leapmotion/ProjectNorthStar/README.md

# Project North Star

Project North Star Headset (http://blog.leapmotion.com/northstar/)

Community organized instructions here: https://project-north-star.gitbook.io/project-north-star/

Hardware BOM, fabrication, and assembly instructions start here: https://github.com/leapmotion/ProjectNorthStar/tree/master/Mechanical

Software setup and calibration starts here: https://github.com/leapmotion/ProjectNorthStar/tree/master/Software

## Additional Resources

* Join the community for the bleeding edge updates on [Discord](https://discord.gg/NghjdX7)
* Scroll through the latest posts on [Reddit](https://www.reddit.com/r/ProjectNorthStar/)
* Keep up with our project updates on [Leap Motion Blog](http://blog.leapmotion.com/)
