leapmotion/ProjectNorthStar/Electronics/README.md

# Project North Star: Electronics

These folders contain the Schematic, Firmware, and Bill of Materials used in building and programming the display driver board on the Project North Star AR Headset.
