leapmotion/ProjectNorthStar/Mechanical/imgs/exploded-view.png

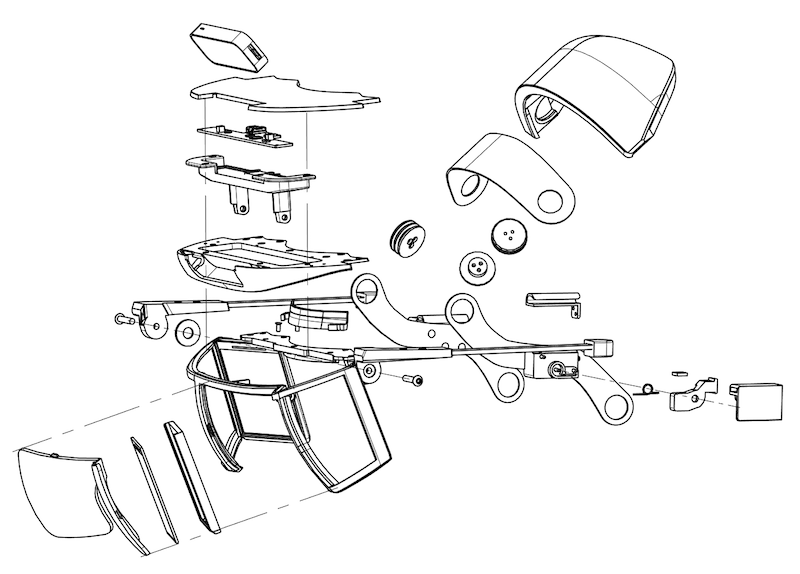
Mechanical/imgs/exploded-view.png
