leapmotion/ProjectNorthStar/Mechanical/imgs/headgear-crossection.jpg

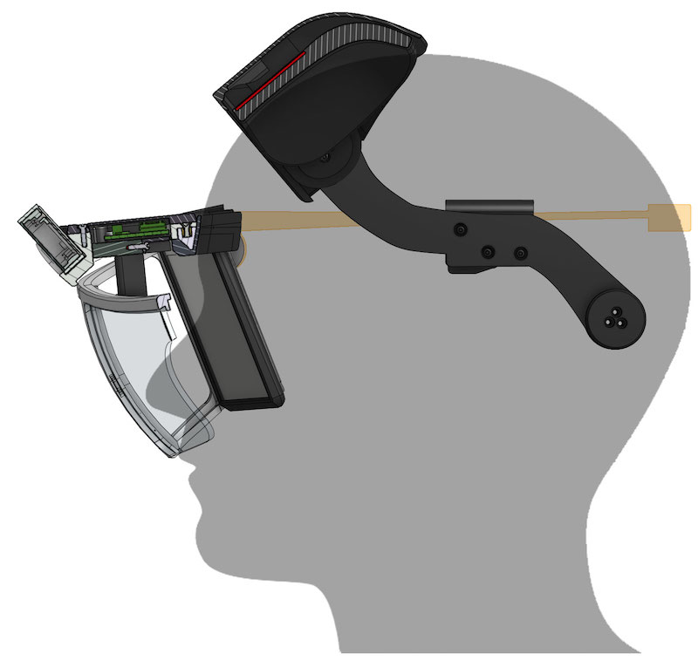
Mechanical/imgs/headgear-crossection.jpg
