leapmotion/ProjectNorthStar/Mechanical/imgs/hero-north-star-release.jpg

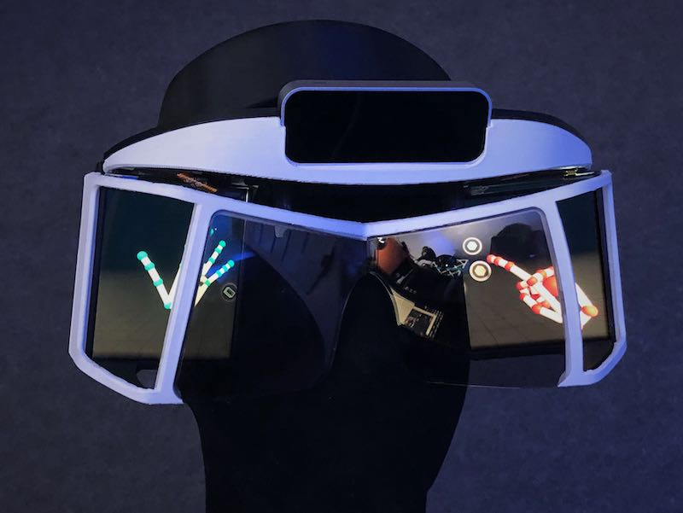
Mechanical/imgs/hero-north-star-release.jpg
