leapmotion/ProjectNorthStar/Mechanical/imgs/north-star-release-3.jpg

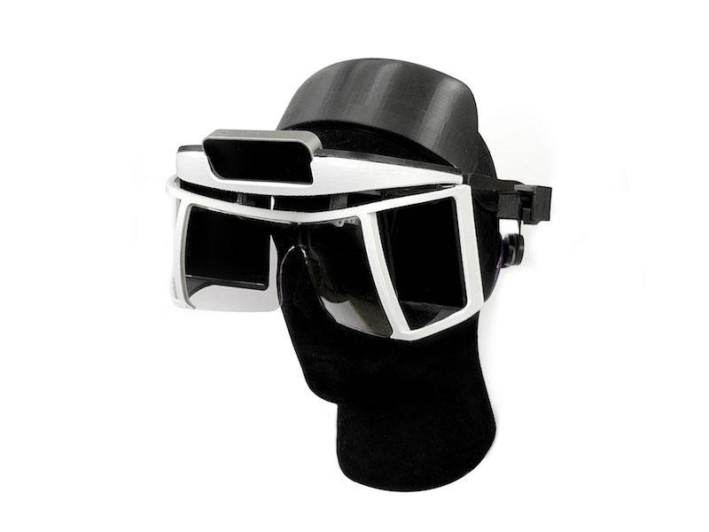
Mechanical/imgs/north-star-release-3.jpg
