leapmotion/ProjectNorthStar/Electronics/Hardware/Bill of Materials-Project North Star.xls

Designator | Description | Quantity | Manufacturer | Manufacturer P/N | Supplier | Supplier P/N
C2, C3, C4, C11, C12, C13, C15, C17, C19, C21, C23, C25 | Capacitor, 0.1uF, 10V, 10%, 0201, Ceramic, X5R | 12 | Murata | GRM033R61A104KE15D | Mouser | 581-81-GRM033R61A104KE5D
C5, C6, C10, C14, C16, C18, C20, C22, C24, C35, C37, C40, C41, C55, C56, C57, C60 | Capacitor, 1.0uF, 10V, 10%, 0402, Ceramic, X5R | 17 | TDK | C1005X5R1A105K050BB | Digikey | 445-4114-6-ND
C7, C8 | Capacitor, 6pF, 50V, 0.1pF, 0201, Ceramic, C0G(NP0) | 2 | Murata | GRM0335C1H6R0BA01D | Digikey | 490-11339-1-ND
C9 | Capacitor, 2.2uF, 6.3V, 20%, 0402, Ceramic, X5R | 1 | TDK | C1005X5R0J225M050BC | Digikey | 445-4999-1-ND
C26, C27, C49, C50 | Capacitor, 18pF, 50V, 2%, 0201, Ceramic, C0G(NP0) | 4 | Murata | GRM0335C1H180GA01D | Digikey | 490-11310-1-ND
C28, C29, C30, C31, C32, C33, C38, C39, C42, C43, C44 | Capacitor, 10uF, 10V, 10%, 0603, Ceramic, X5R | 11 | Murata | GRM188R61A106KE69D | Digikey | 490-10474-1-ND
C34 | Capacitor, 15pF, 50V, 2%, 0201, Ceramic, C0G(NP0) | 1 | Murata | GRM0335C1H150GA01D | Digikey | 490-11309-1-ND
C36, C58, C59 | Capacitor, 12pF, 50V, 2%, 0201, Ceramic, C0G(NP0) | 3 | Murata | GRM0335C1H120GA01D | Digikey | 490-11308-1-ND
C45, C46, C47, C48 | Capacitor, 47uF, 10V, 20%, 0805, Ceramic, X5R | 4 | Murata | GRM21BR61A476ME15L | Mouser | 81-GRM21BR61A476ME15L
C51, C52, C53, C54, C61, C62 | Capacitor, 10uF, 50V, 10%, 1206, Ceramic, X7R | 6 | Samsung | CL31B106KBHNNNE | Digikey | 1276-6767-1-ND
CON2 | Connector, Generic, Header, 2POS, 2.54mm | 1 | Generic | Generic
D1 | LED, 635nm, 140deg, , 20mA, , 1.6mm x 0.8mm, -30C - 85C | 1 | Dialight | 598-8010-107F | Mouser | 645-598-8010-107F
D2, D3, D4, D5 | Diode, -40C - 150C, SOD-323 | 4 | Toshiba | CUS10S40,H3F | Mouser | 757-CUS10S40H3F
D6 | LED, 593nm, 140deg, , 20mA, , 1.6mm x 0.8mm, -30C - 85C | 1 | Dialight | 598-8040-107F | Mouser | 645-598-8040-107F
FB1, FB2, FB3 | FERRITE CHIP BEAD 600 OHM SMD | 3 | TDK | MPZ1608S601A | Digikey | 445-2205-1-ND
J1 | Connector, TE Connectivity, Receptacle, 20POS, 0.9mm | 1 | TE Connectivity | 2129320-3 | Digikey | A120537CT-ND
J2 | Connector, FCI, Right Angle, 12POS, 0.5mm | 1 | FCI | 10051922-1210ELF | Digikey | 609-1236-6-ND
J3, J4 | Connector, Kyocera, Receptacle, 50POS, 0.35mm | 2 | Kyocera | 245863050104829+ | Kyocera | 245863050104829+
L1, L4 | FIXED IND 4.7UH 1.4A 216 MOHM | 2 | Murata | DFE252012R-H-4R7M=P2 | Digikey | 490-10658-1-ND
L2, L3 | INDUCTOR 1.0UH 20% 1600MA 1008 | 2 | Murata | LQM2HPN1R0MG0L | Digikey | 490-5112-1-ND
L5, L6 | Fixed Inductors XAL4040 AEC-Q200 15 uH 20 % 2.8 A | 2 | Coilcraft | XAL4040-153MEB | Mouser | 994-XAL4040-153MEB
LCD1, LCD2 | 3.5inch 1440RGB*1600 TFT-LCD Module | 2 | BOE | VS035ZSM-NW0-69P0 | BOE | VS035ZSM-NW0-69P0
Q1, Q2 | Transistor, NFET_DUAL, 2.2Ohm, 200mA, 120mW, SOT-563, -55C - 150C | 2 | Rohm Semiconductor | EM6K34T2CR | Digikey | EM6K34T2CRCT-ND
R1, R2, R3, R4, R20 | Resistor, 1M, 1/20W, 1%, 0201 | 5 | Panasonic Electronic Components | ERJ-1GEF1004C | Digikey | P1.00MABCT-ND
R6, R7 | Resistor, 4.7K, 1/20W, 1%, 0201 | 2 | Panasonic Electronic Components | ERJ-1GEF4701C | Digikey | P4.70KABDKR-ND
R8, R9, R10, R12, R14, R43 | Resistor, 10K, 1/20W, 5%, 0201 | 6 | Panasonic Electronic Components | ERJ-1GEJ103C | Digikey | P10KAGCT-ND
R11, R13, R15, R21 | Resistor, 1K, 1/20W, 5%, 0201 | 4 | Panasonic Electronic Components | ERJ-1GEJ102C | Digikey | P1.0KAGCT-ND
R16, R18, R19, R24, R32 | Resistor, 0R, 1/10W, Jumper, 0402 | 5 | Panasonic Electronic Components | ERJ-2GE0R00X | Digikey | P0.0JCT-ND
R23 | Resistor, 200K, 1/20W, 1%, 0201 | 1 | Panasonic Electronic Components | ERJ-1GEF2003C | Digikey | P200KABCT-ND
R25 | Resistor, 36.5K, 1/20W, 1%, 0201 | 1 | Panasonic Electronic Components | ERJ-1GEF3652C | Digikey | P36.5KABCT-ND
R26 | Resistor, 560K, 1/20W, 1%, 0201 | 1 | Yageo | RC0201FR-07560KL | Digikey | YAG2728CT-ND
R27, R34 | Resistor, 30K, 1/20W, 1%, 0201 | 2 | Panasonic Electronic Components | ERJ-1GEF3002C | Digikey | P30.0KABCT-ND
R28, R29 | Resistor, 150K, 1/20W, 1%, 0201 | 2 | Panasonic Electronic Components | ERJ-1GEF1503C | Digikey | P150KABCT-ND
R30 | Resistor, 715K, 1/20W, 1%, 0201 | 1 | Yageo | RC0201FR-07715KL | Digikey | YAG2785CT-ND
R31 | Resistor, 10R, 1/10W, 1%, 0402 | 1 | Panasonic | ERJ-2RKF10R0X | Mouser | 667-ERJ-2RKF10R0X
R33 | Resistor, 90.9K, 1/20W, 1%, 0201 | 1 | Panasonic Electronic Components | ERJ-1GEF9092C | Digikey | P90.9KABCT-ND
R35, R36 | Resistor, 750K, 1/20W, 1%, 0201 | 2 | Panasonic Electronic Components | ERJ-1GEF7503C | Digikey | P750KABCT-ND
R37, R38 | Resistor, 130K, 1/20W, 1%, 0201 | 2 | Panasonic Electronic Components | ERJ-1GEF1303C | Digikey | P130KABCT-ND
R39, R41 | Resistor, 49.9K, 1/20W, 1%, 0201 | 2 | Panasonic Electronic Components | ERJ-1GEF4992C | Digikey | P49.9KABCT-ND
R40, R42 | Resistor, 62K, 1/20W, 1%, 0201 | 2 | Panasonic Electronic Components | P62.0KABDKR-ND | Digikey | P62.0KABDKR-ND
S3 | Switch, SPST-NO, Button, 4.6mm x 3.2mm | 1 | ALPS | SKRPABE010 | Mouser | 688-SKRPAB
U1 | TVS DIODE 5VWM 15VC SLP2611N9T | 1 | Semtech | RCLAMP7528T.TNT | Digikey | RCLAMP7528T.TNTCT-ND
U2 | DisplayPort 1.4-to-Dual MIPI Output Converter | 1 | Analogix | ANX7530 | Analogix | ANX7530
U3 | IC MCU 32BIT 256KB FLASH 48QFN | 1 | Atmel | ATSAMD21G18A-MU | Digikey | ATSAMD21G18A-MU-ND
U4, U6 | IC REG BUCK ADJ 1.2A SYNC 8WSON | 2 | TI | TLV62080 | Digikey | 296-39270-1-ND
U5 | IC REG BCK BST INV ADJ DL 24VQFN | 1 | TI | TPS65131-Q1 | Digikey | 296-40865-1-ND
U7, U8 | IC LED DRIVER 20TSSOP | 2 | TI | TPS61194-Q1 | Digikey | 296-43817-1-ND
U9 | 3.3V LDO Voltage Regulators 250mA Ultra-Lo Noise LDO Reg | 1 | TI | LP5907MFX-3.3NOPB | Mouser | 595-LP5907MFX-3.3NOPB
Y1 | Crystal, 24MHz, 6pF, 4-SMD (2x1.6) | 1 | Abracon | XRCGB24M000F2P0R0 | Mouser | 81-XRCGB24M000F2P0R0
Y2 | Crystal, 32.768KHz, 12.5pF, 2-SMD(3.2x1.5) | 1 | Abracon | ABS07-32.768KHZ-T | Mouser | 815-ABS07-32.768KHZ-T
Y3 | Crystal, 16MHz, 10pF, 4-SMD (2x1.6) | 1 | Abracon | ABM11-16.000MHZ-D2X-T3 | Digikey | 535-12629-1-ND
