leapmotion/ProjectNorthStar/Electronics/Hardware/Display Board/OUTPUT/PCB Prints/0084 - AR Display Board Rev2.1.PDF

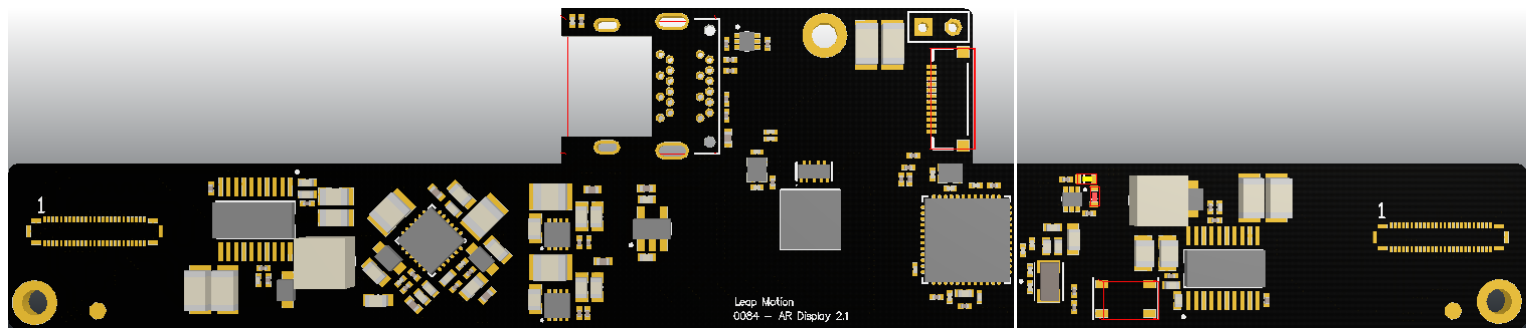
[picture p10: figure]

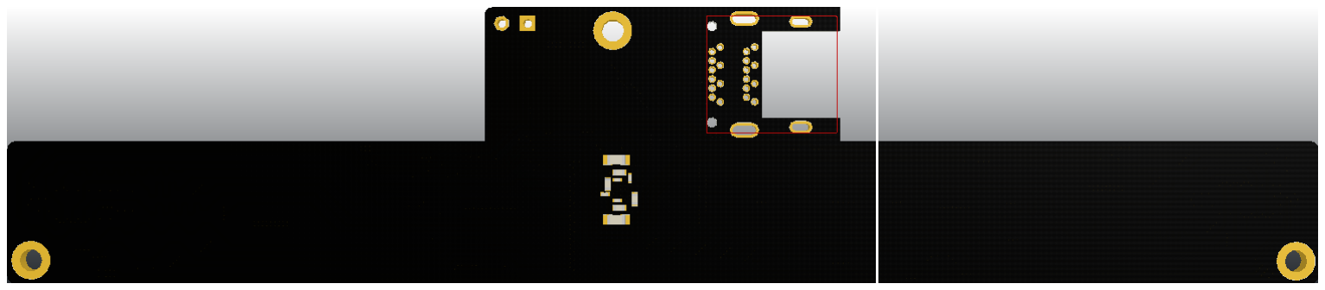
[picture p11: figure]
