leapmotion/ProjectNorthStar/(threads)

Thread 2 (2018-06-08):

Unreal support ?

dsanjit, 2018-06-08:
Can we get Unreal support as well ?

hacky97, 2018-06-22:
[Godot ](https://github.com/BastiaanOlij/gdleapmotion)is actually C++ libs, so [using ](https://docs.unrealengine.com/en-us/Programming)it in Unreal engine should be a [blaze](https://vignette.wikia.nocookie.net/monstermovies/images/f/fc/Minecraft_Blaze.png/revision/latest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).

eray-ozer, 2018-11-06:
explcan you be more specific for your explenation ?

lumbbumba, 2019-07-17:
Is there any way to get an official answer about UE4 support? Because putting 2 cameras in a pawn will not do it. It would be nice to have more another big engine beside unity.

zfarm, 2019-08-20:
Does anyone know if there's anything more on Unreal northstar support? Or someone who has it working?

ffreality, 2019-09-18:
Leap Motion works with UE4
Display is about colorful thing in black screen
Only thing we should work on is screen display. I think we can create a display system with render target. We can create a mesh with a special UV (I dont think about coordinates yet) and we can give it a render target based material from camera. And we can put it in front of user's eye. We can do that.

zfarm, 2019-09-21:
I suspect we can just pull the deformation mesh from Unity and retarget?

BryanChrisBrown, 2020-01-24:
https://github.com/druidsbane/openvr-northstar

My team and I recently finished the steamvr driver for project Northstar. It's compatible with any engine you wish to use.

Thread 3 (2018-06-09):

Support to Godot Engine 3.1

timoteo7, 2018-06-09:
https://github.com/BastiaanOlij/gdleapmotion

BastiaanOlij, 2018-06-13:
Once its possible to actually get a Project North Star device, I'll definitely add support for it.

BryanChrisBrown, 2020-01-24:
https://github.com/druidsbane/openvr-northstar

My team and I recently finished the steamvr driver for project Northstar. It's compatible with any engine you wish to use.

@BastiaanOlij @timoteo7

Thread 4 (2018-06-19):

missing Gerber files for electronics production

ajaykarpur, 2018-06-19:
I noticed that the electronics folder includes a BOM and schematics, but the Gerber files are not available. Are there plans to make these files available?

Also, will we be able to purchase the custom components like the reflectors and the infrared LED/camera array directly from Leap Motion?

Thank you!

Ybalrid, 2018-06-23:
as I understand, they intend to sell the electronics module for less than $100. For the reflectors, I am unsure they will be part of that package.

A got a quote from protolabs to mill them from PMMA (acrylic), and it's about €130 each. There's somebody on twitter from Japan that got them made that way, and then polished them nicely and added some semi-mirror film on them, and he's geeting a good reflection from some LCD screen. He took pictures from a camera inside a dummy head.

https://twitter.com/yamaulab/status/1007888133239668737

It would be nice to see these reflectors made at some kind of scale to get the cost down. Custom manufacturing for them is pricy if you don't have access to a CNC... :/

Ybalrid, 2018-06-23:
Also, important thing, the "led and camera array" is the "next generation hand tracking module". This they aren't open sourcing. They are open sourcing everything else.

See this conversation with them on Twitter https://twitter.com/LeapMotion/status/1009815616163901447

Thread 8 (2018-06-28):

Two STL files contain too much

abrain, 2018-06-28:
Inside the file `Mechanical/North Star 3D Files/3D Prints.zip` the files `cheek guard - left.stl` and `optics bracket.stl` are identical. Both files contain the optics bracket and cheek guards combined. Looking at the file names I suspect they should contain the respective part only.

abrain, 2018-06-28:
Has been fixed with latest commit

Closed 2018-06-28.

Thread 12 (2018-07-26):

Lenses

Phara0h, 2018-07-26:
For now can we get the manufacturer you used to get the lenses made regardless of the cost?

Phara0h, 2018-10-05:
@jselstad  Any updates on getting this, I can literally fabricate everything else of project north star beside the lens.

Phara0h, 2018-11-21:
> @Phara0h, I just got T1 samples from the injection mold I had made. Still working on the coatings. I’ll make them available inexpensively as soon as possible.

You sir are a good man. If you need some boards made (assembled) I can get those done for you for cheap since I own a PnP machine and reflow oven.

simon-heinen, 2018-12-25:
https://www.smart-prototyping.com/Project-North-Star-Lens Here you can now pre-order them (not my page, just found it)

Thread 20 (2018-10-07):

Electronics pcbs and B.O.M

Tondy, 2018-10-07:
Hello.

I have been trying to get the PCBs for the projects. Through a Fab lab I can see the BOM and the other
folders like the Display drivers folder and gerber. But its no clear what is what. On the guide the electronics part says coming soon

https://leapmotion.github.io/ProjectNorthStar/

Has anyone got helpful information?

Kind regards.

Thread 22 (2018-12-05):

Does anyone sell the Display Board?

alonperl, 2018-12-05:
Hi, I am trying to make the North Star but I stuck with creating the board
Maybe someone has a spare board, otherwise can link me to the right manufacturer that can print this board?

Thanks

NoahNOA, 2019-01-28:
Hi @alonperl , the company I work with has 100pcs of the PCB fabricated, and we have all of the components, but because of Chinese New Year, we won't be able to get them assembled and shipped until March. :(

capnmidnight, 2019-01-28:
> Hi @alonperl , the company I work with has 100pcs of the PCB fabricated, and we have all of the components, but because of Chinese New Year, we won't be able to get them assembled and shipped until March. :(

Anyway I can get on an order list?

NoahNOA, 2019-01-28:
https://www.smart-prototyping.com/Project-North-Star-Display-Driver-Board

On Mon, Jan 28, 2019 at 11:48 PM Sean T. McBeth <notifications@github.com>
wrote:

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
--
Noah
Noah Zerkin
R&D Project Manager
noah@noa-labs.com
+86 185 6623 6421 <http://noa-labs.com/>
<https://cn.linkedin.com/in/noahz> <https://plus.google.com/+Noa-labs>
<https://twitter.com/noalabs> <https://www.facebook.com/noalabs/>
<http://noa-labs.com/>
 We bring you from Idea to Market

colejd, 2019-03-06:
@NoahNOA Hello! Just wondering before I order the board, are the board/lenses/screens compatible with the changes Leap Motion made in [Mechanical Update 3](http://blog.leapmotion.com/project-north-star-mechanical-update-3/)?

NoahNOA, 2019-03-07:
Hi Jonathan,

They are, indeed!

Best,
Noah
Noah Zerkin
R&D Project Manager
noah@noa-labs.com
+86 185 6623 6421 <http://noa-labs.com/>
<https://cn.linkedin.com/in/noahz> <https://plus.google.com/+Noa-labs>
<https://twitter.com/noalabs> <https://www.facebook.com/noalabs/>
<http://noa-labs.com/>
 We bring you from Idea to Market

On Thu, Mar 7, 2019 at 12:31 AM Jonathan Cole <notifications@github.com>
wrote:

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

Thread 34 (2019-02-15):

Printing 120-002

MatoXD99, 2019-02-15:
Is there anyone that could help me with that model? As you know, it's really weird and I have 0 ideas on how to place it, so I can print it nicely. I've tried just laying it, but that will most definitely not work or I mean it didn't work. So any tips?

keeganpops, 2019-04-29:
Go to
https://discordapp.com/invite/NghjdX7
There's a bigger community to help you!

Thread 42 (2020-07-11):

Missing STL for v3.1 Release

ajlennon, 2020-07-11:
Hi guys,

Great project. We're trying to print the mechanicals here at DoES Liverpool. I can't find this from v3.1 BOM. Can somebody point me in the right direction please? [Edit: i.e. can't spot it in the 3D files zip]

#110-005 | 1 | LEFT SLIDE ENDCAP - 3DPRINT

BryanChrisBrown, 2020-08-01:
Hey @ajlennon I believe we already answered this on the discord, however the end cap piece is intended to just be mirrored in your slicer software. Here's a link to a video on how to do that. https://www.youtube.com/watch?v=ahU7GWtRXQo

ajlennon, 2020-08-01:
Thanks @BryanChrisBrown !

Closed 2020-08-01.

Thread 49 (2022-05-11):

dualStereoChessboardCalibration.py - cameras not populating calibration screen"

Luseno64, 2022-05-11:
my environment variables are set, but the issue that I am running into is that the expected 4 windows are not populating. Any ideas?

```
python dualStereoChessboardCalibration.py
No Calibration file found...
```
Above is the output. No calibration screen.
