leapmotion/ProjectNorthStar/Electronics/Hardware/Schematic-Project North Star.PDF

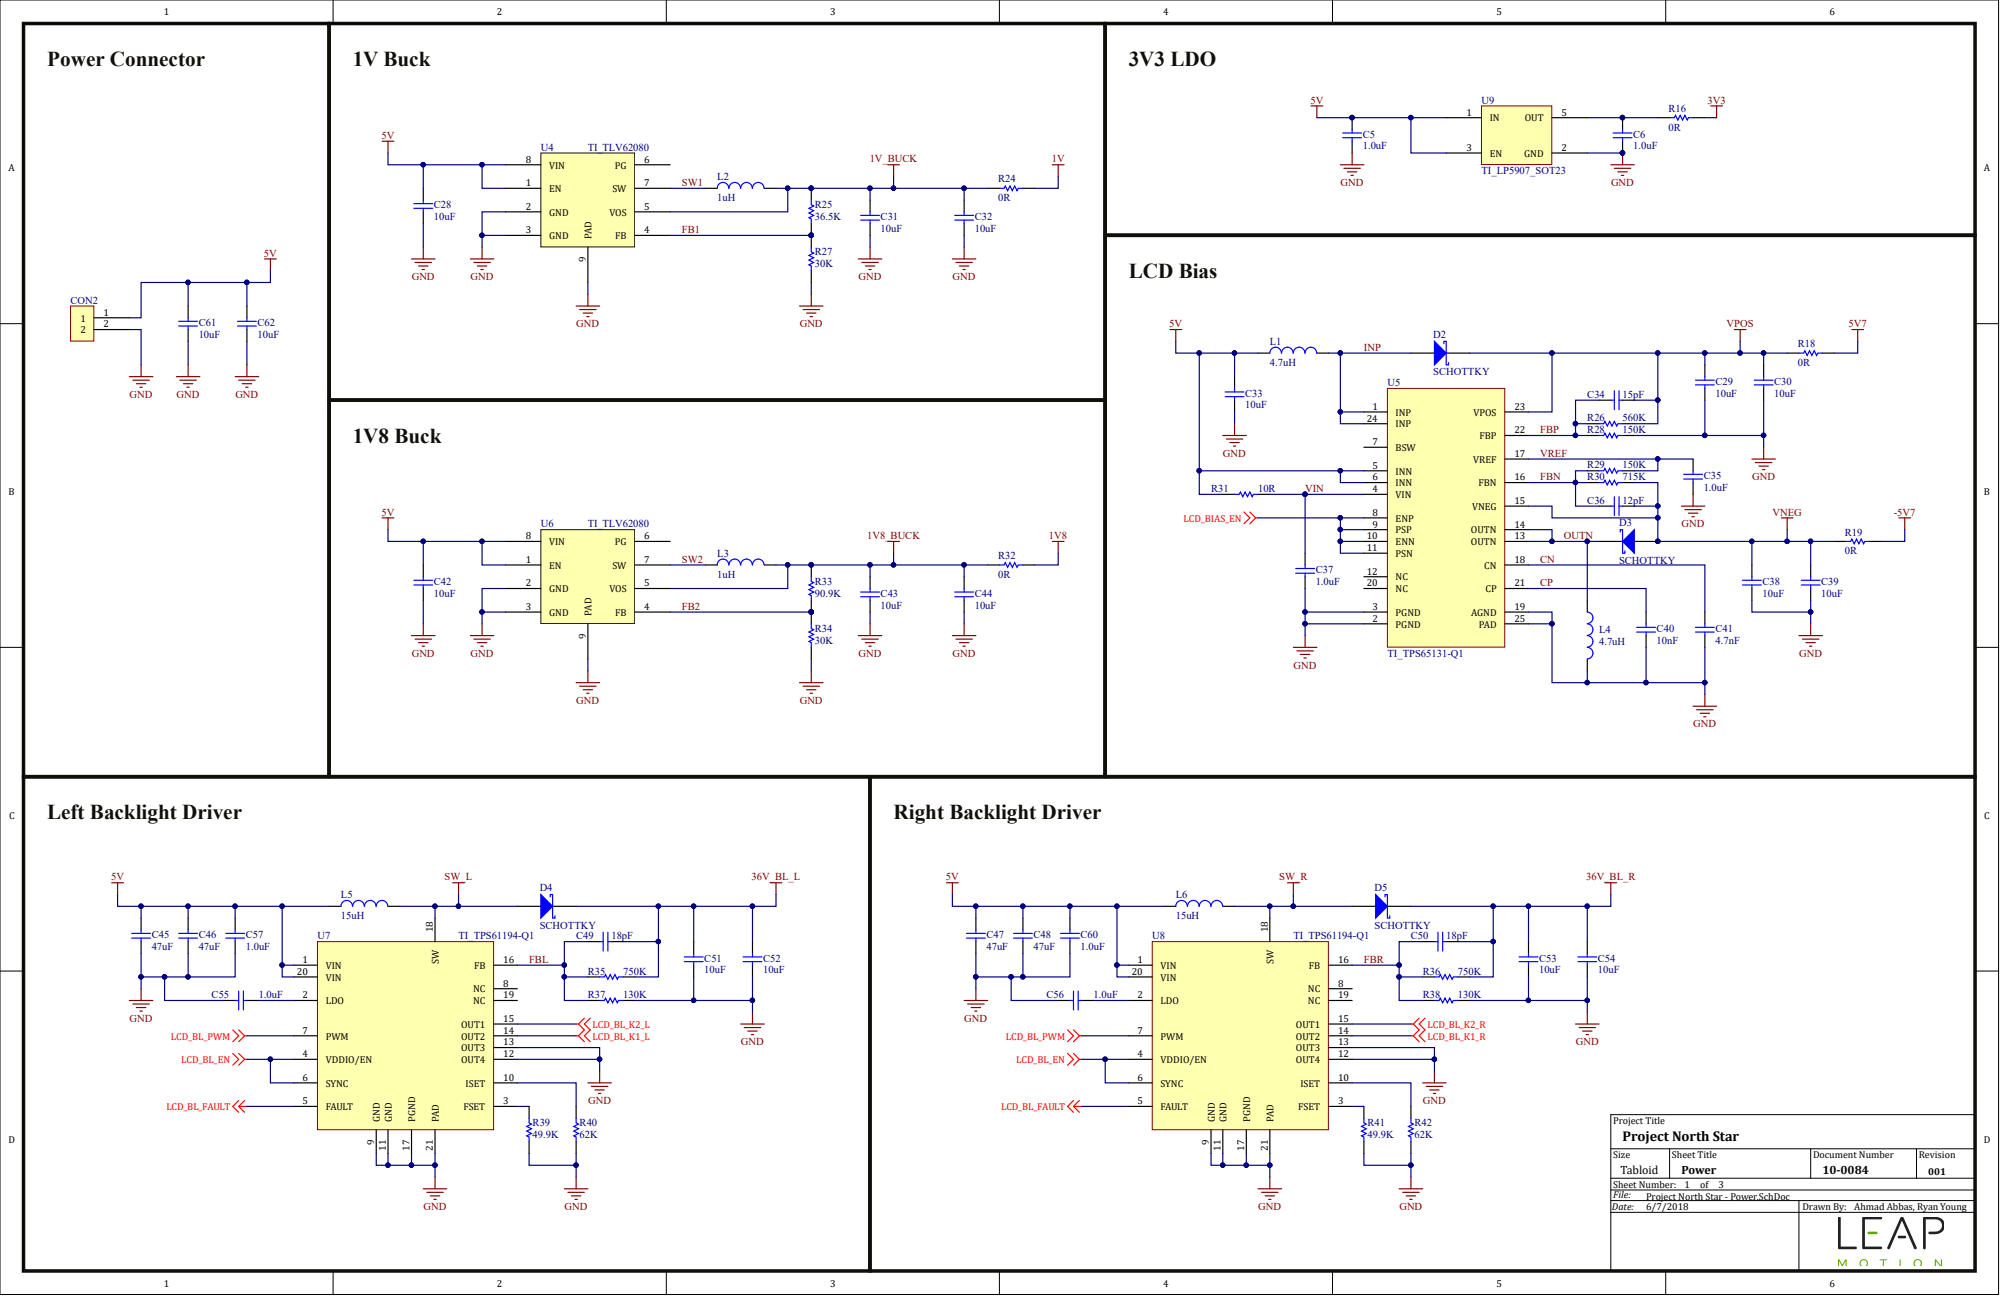
[picture p15: page 1]

SCHOTTKY U5

INP 1

Project North Star - Power.SchDoc

Ahmad Abbas, Ryan Young

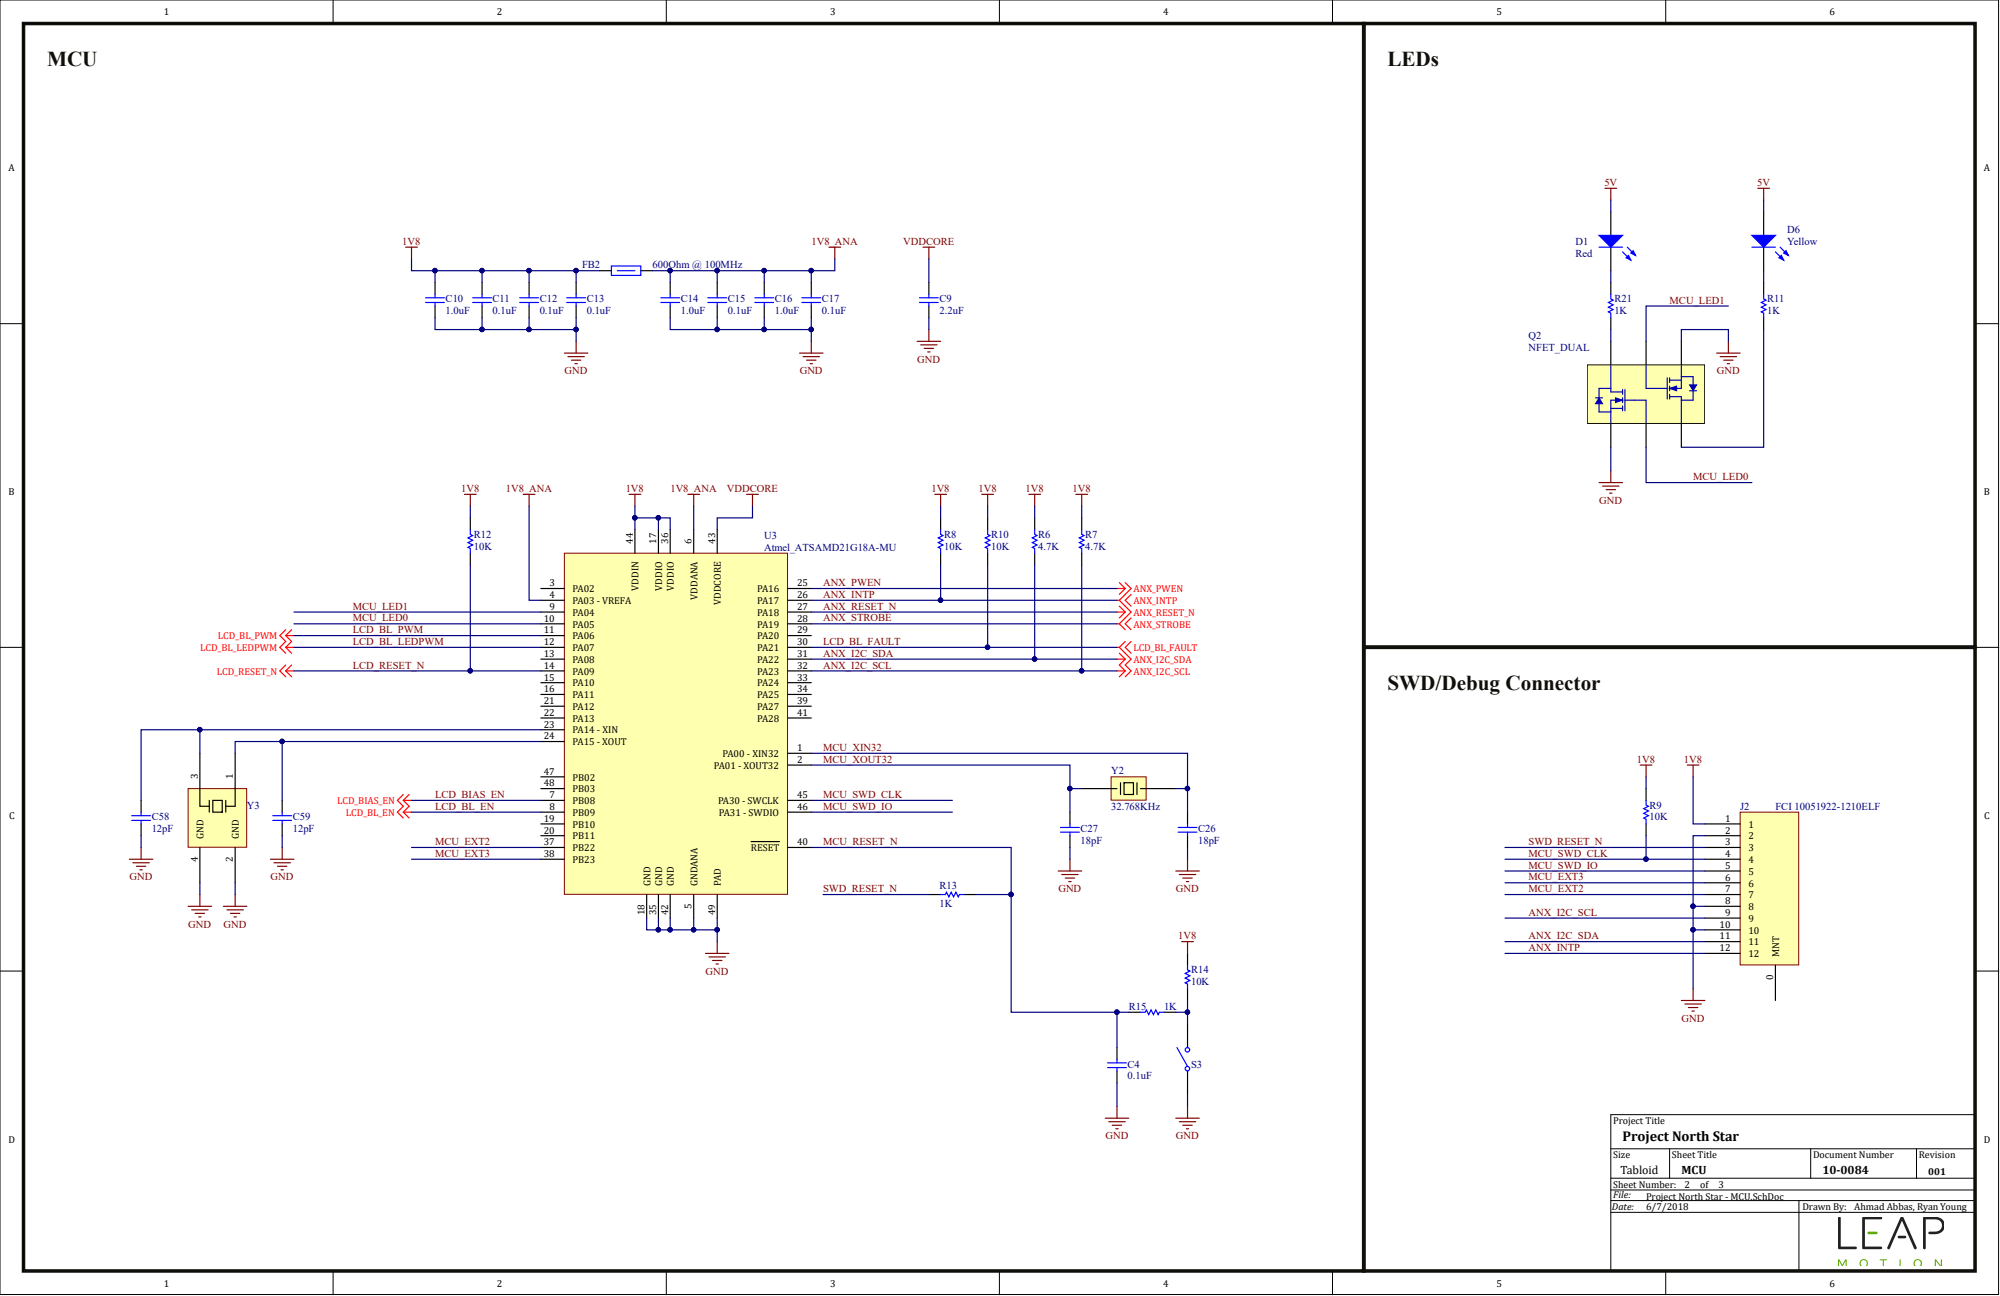
[picture p16: page 2]

PA14 - XIN 23 PA15 - XOUT 24 | 1

PB10 19 | | MCU_SWD_CLK MCU_SWD_IO | C27

Project North Star - MCU.SchDoc

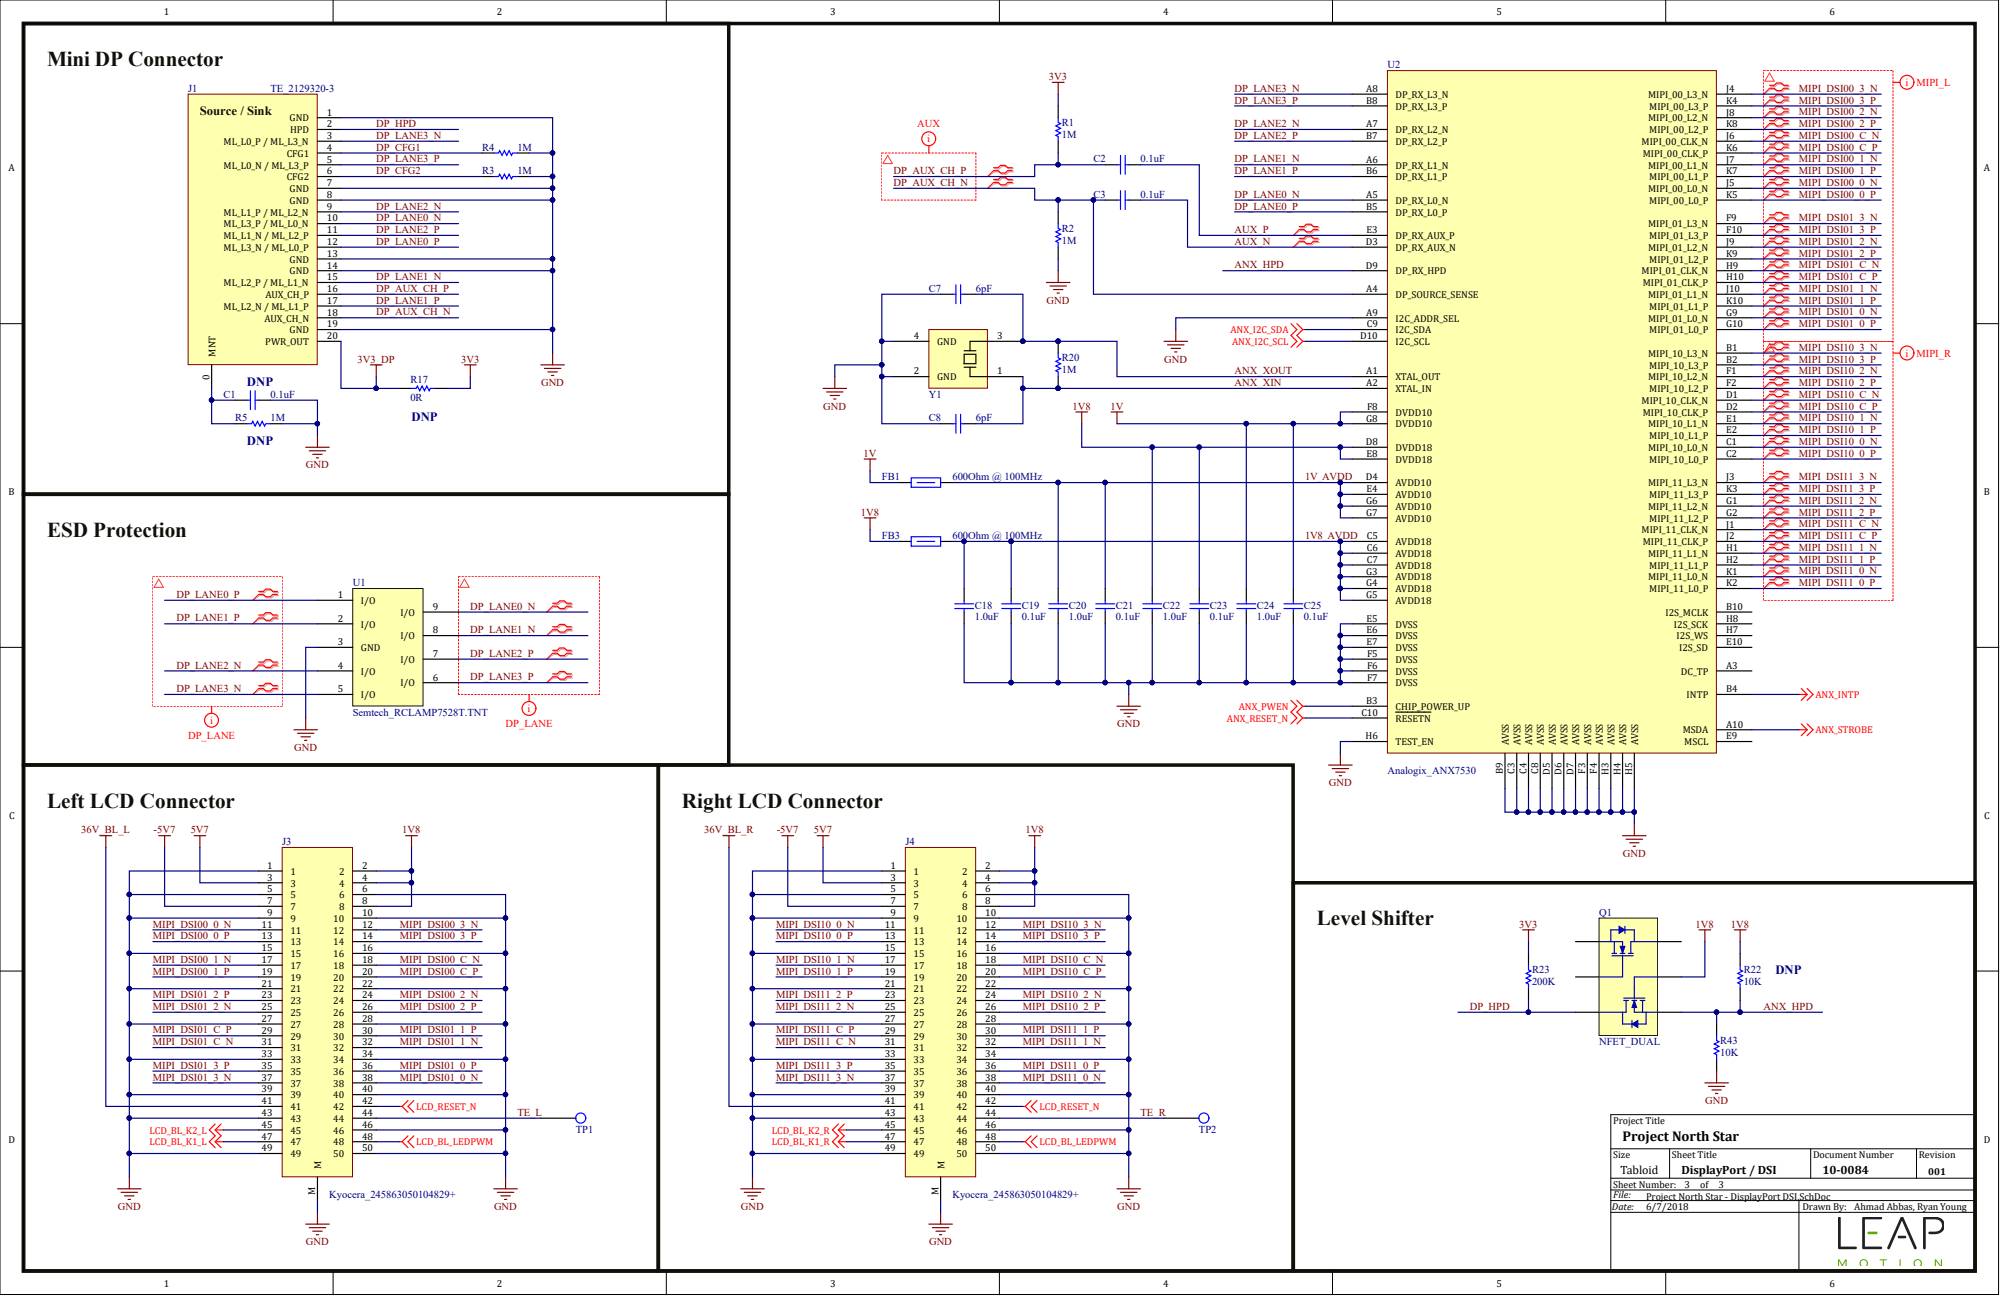
[picture p17: page 3]

AVSS H4 AVSS H3 AVSS F4 AVSS F3 AVSS D7 AVSS D6 AVSS D5 AVSS C8 AVSS C4 AVSS C3 AVSS B9

Project North Star - DisplayPort DSI.SchDoc

Ahmad Abbas, Ryan Young
