leapmotion/ProjectNorthStar/Electronics/Hardware/Display Board/OUTPUT/ASY/0084 - AR Display Board Rev2.1.PDF

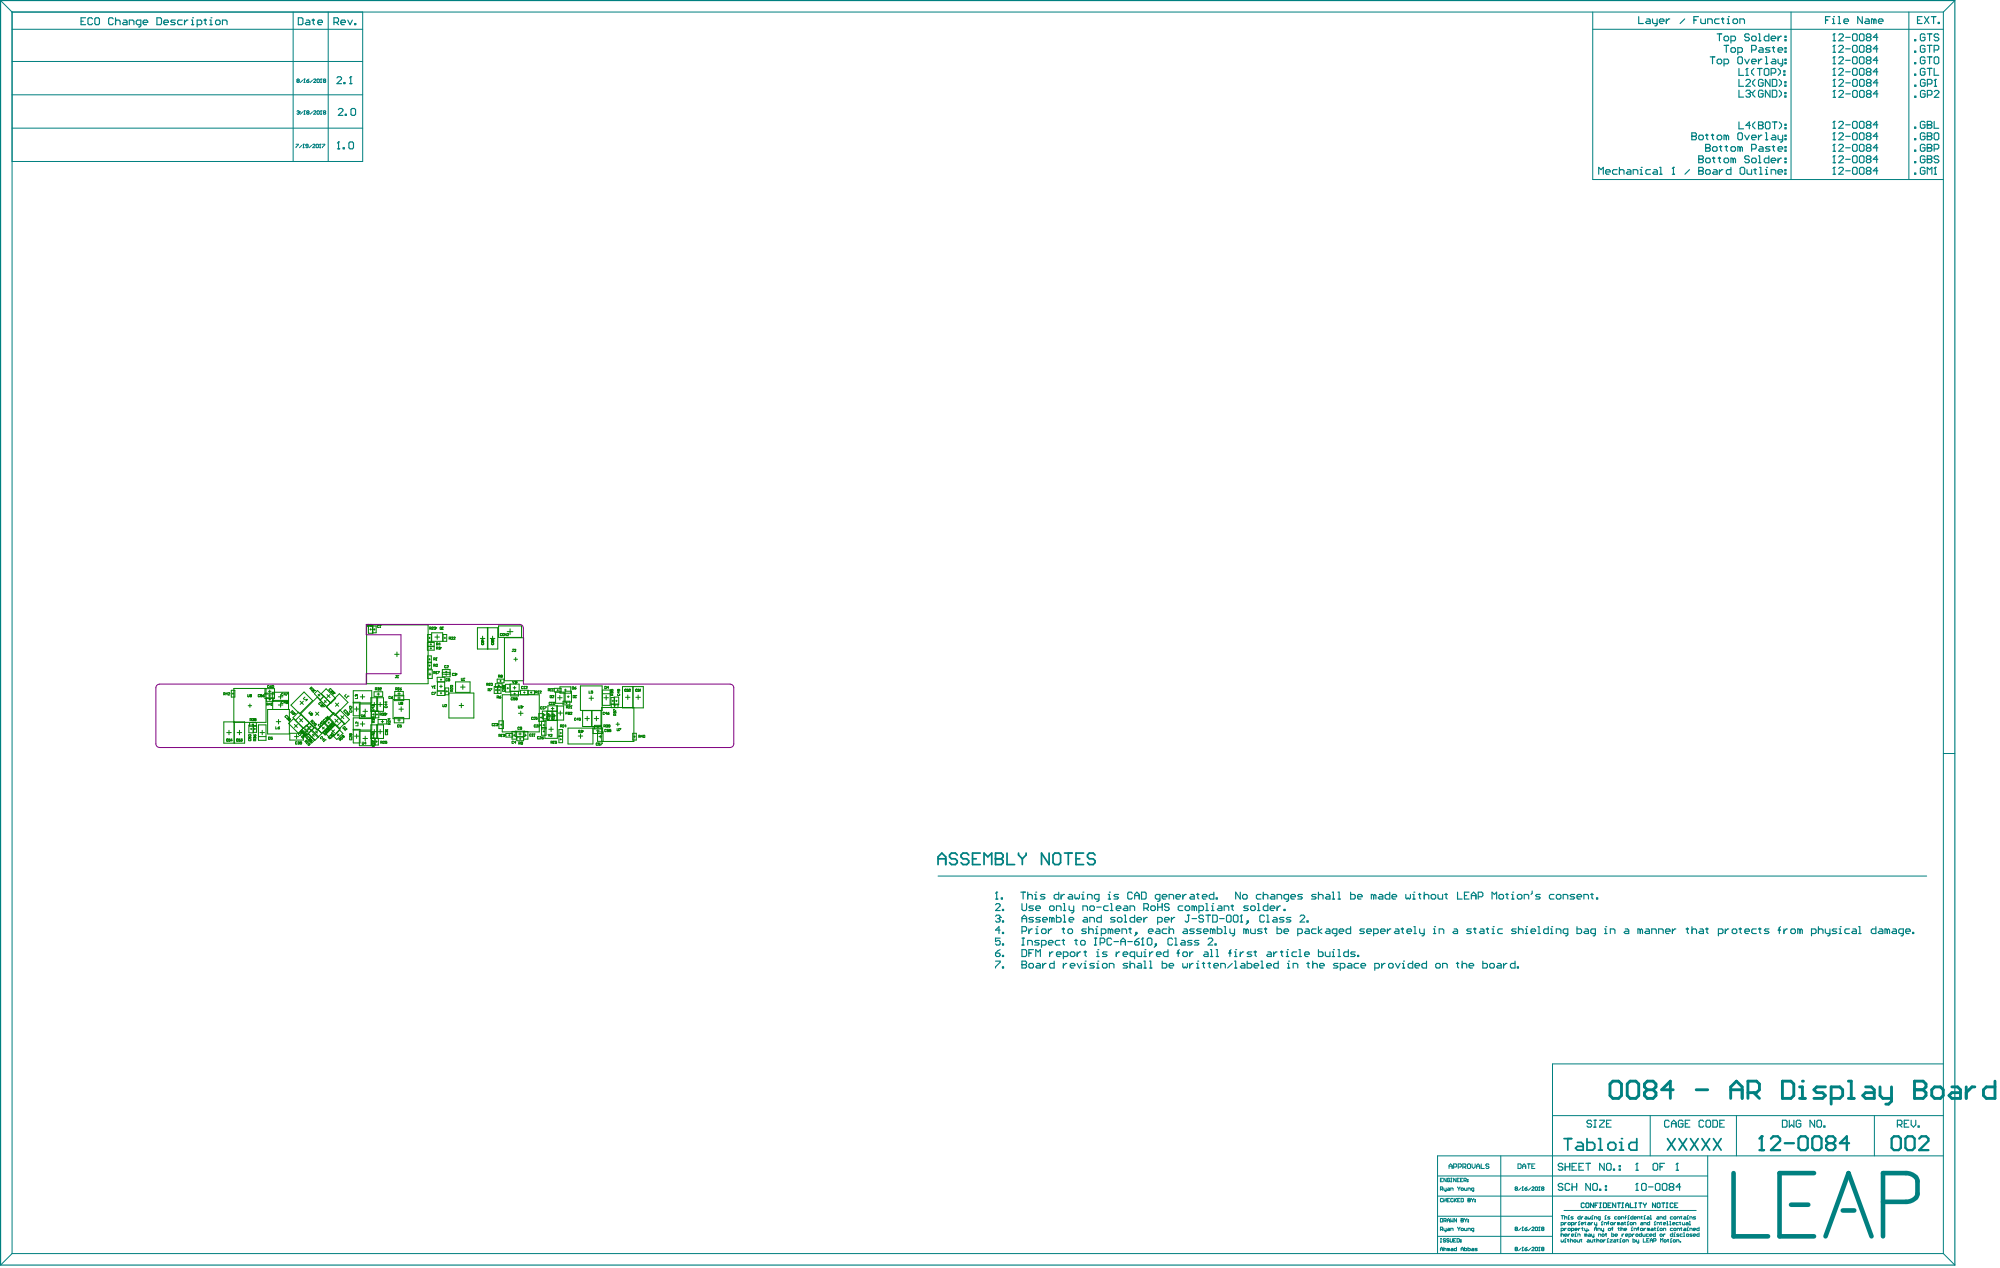
[picture p18: page 1]

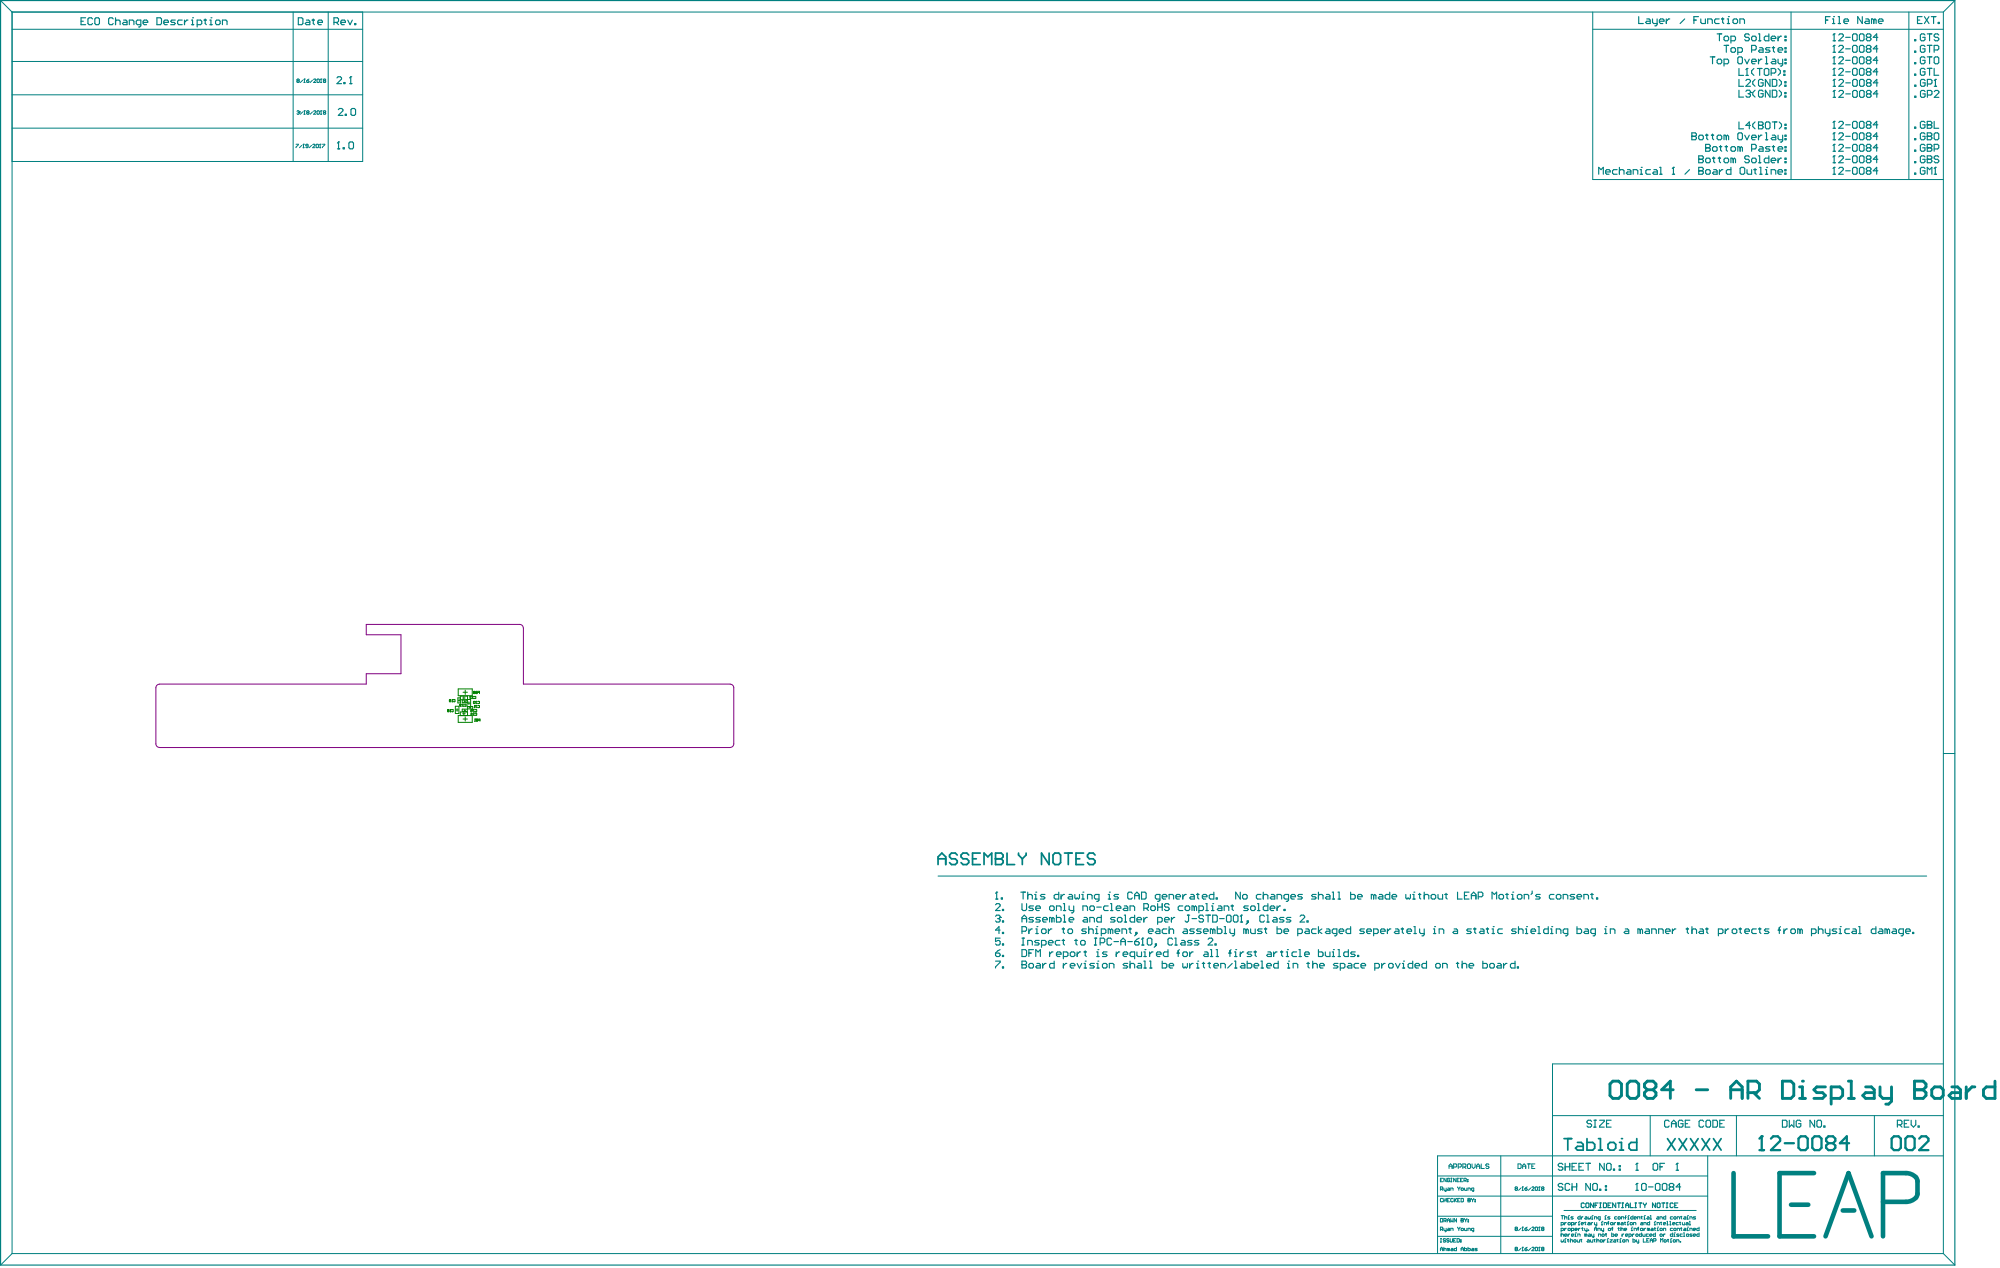
[picture p19: page 2]
