leapmotion/ProjectNorthStar/Electronics/Hardware/Display Board/OUTPUT/Schematic Print/0084 - AR Display Board Rev2.1.PDF

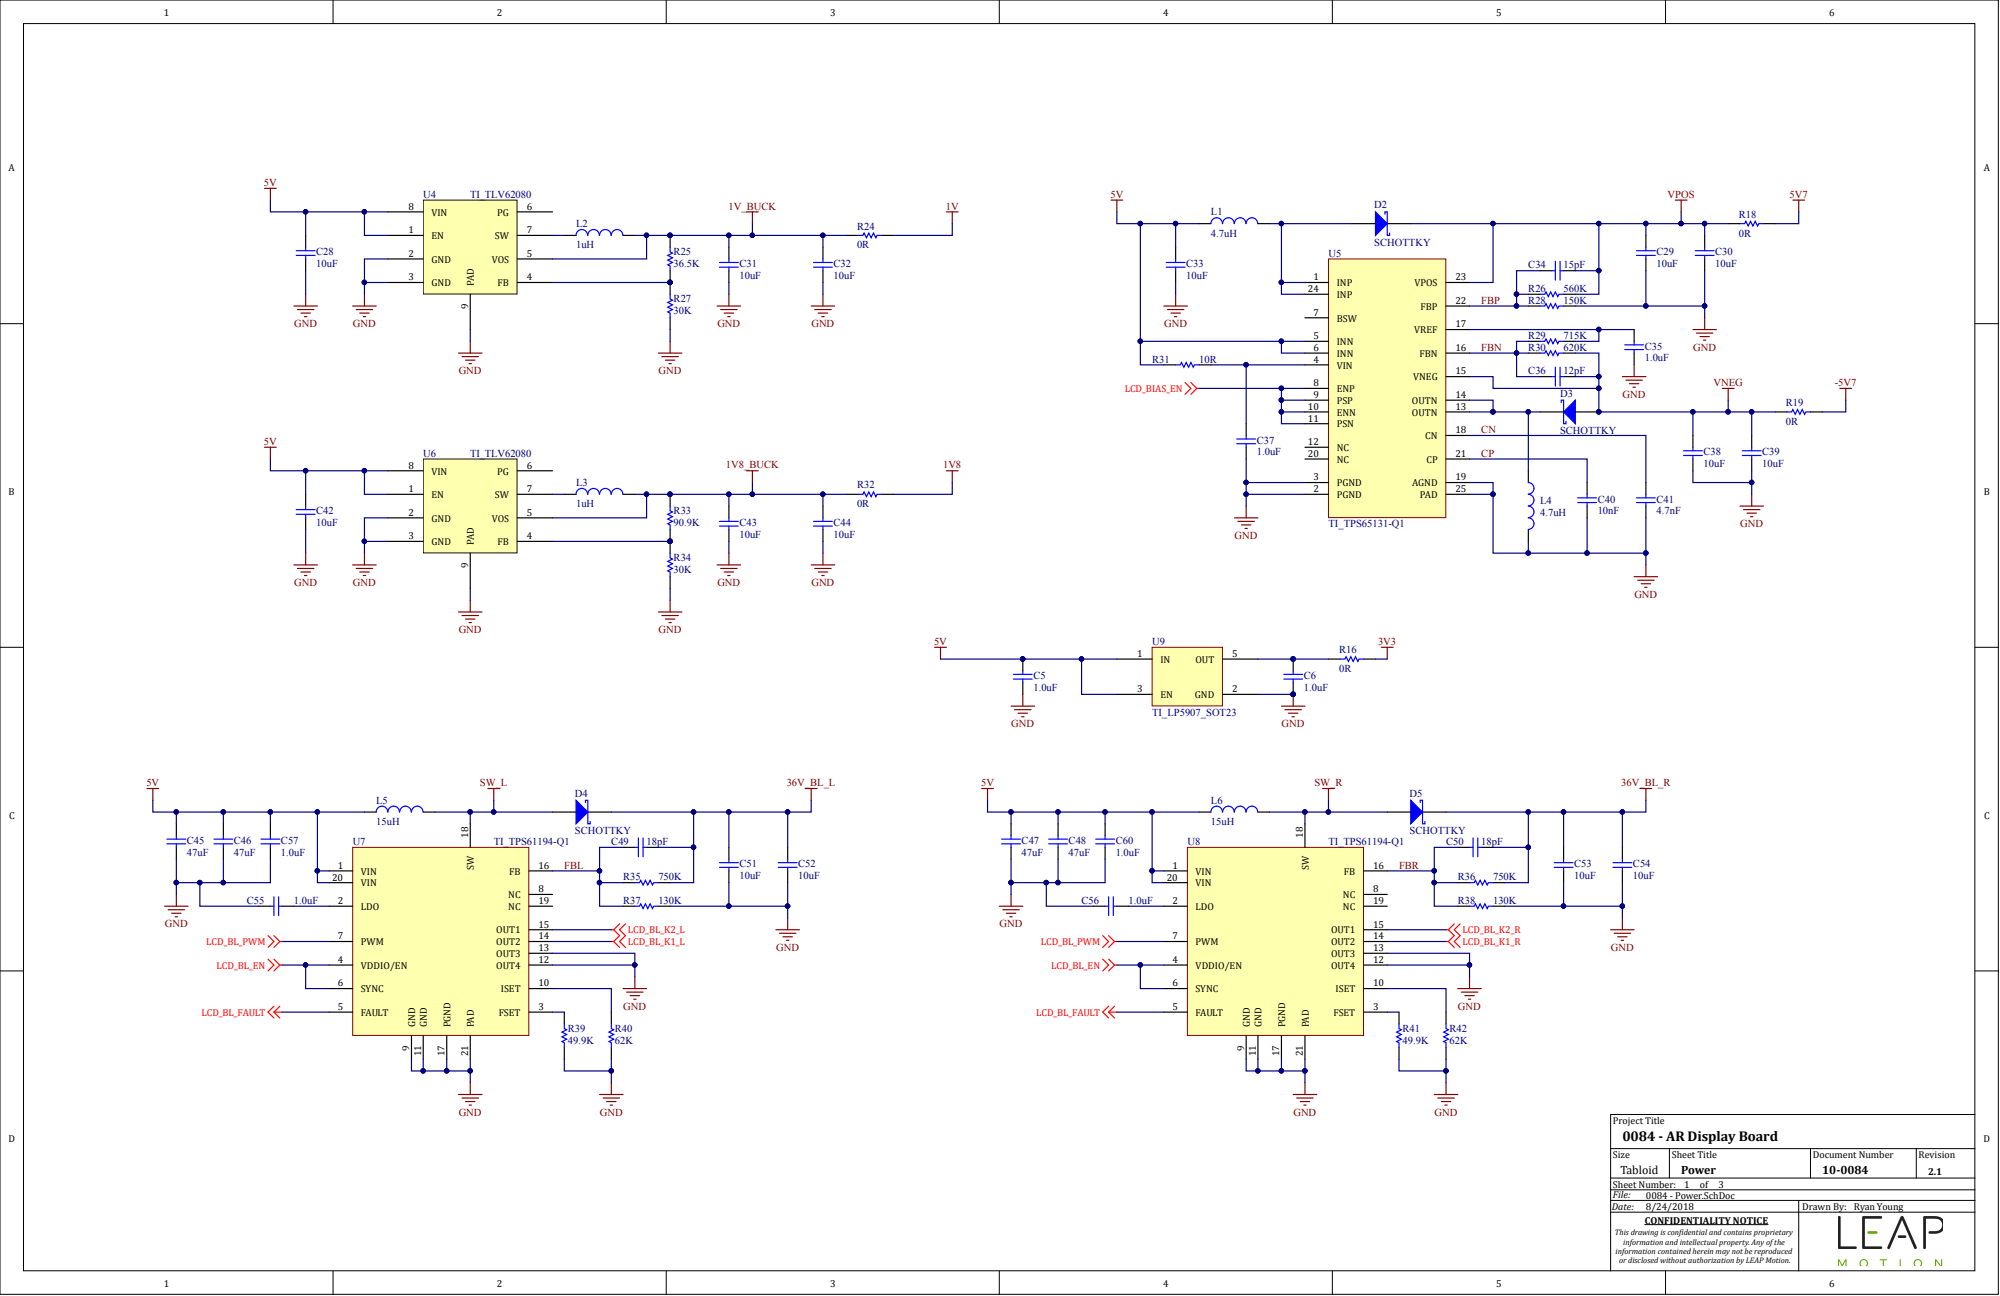
[picture p20: page 1]

GND 2

INP 1
INP 24 CN CP

PSP 9
ENN 10
PSN 11 | 18 CN

This drawing is confidential and contains proprietary
information and intellectual property. Any of the
information contained herein may not be reproduced
or disclosed without authorization by LEAP Motion.

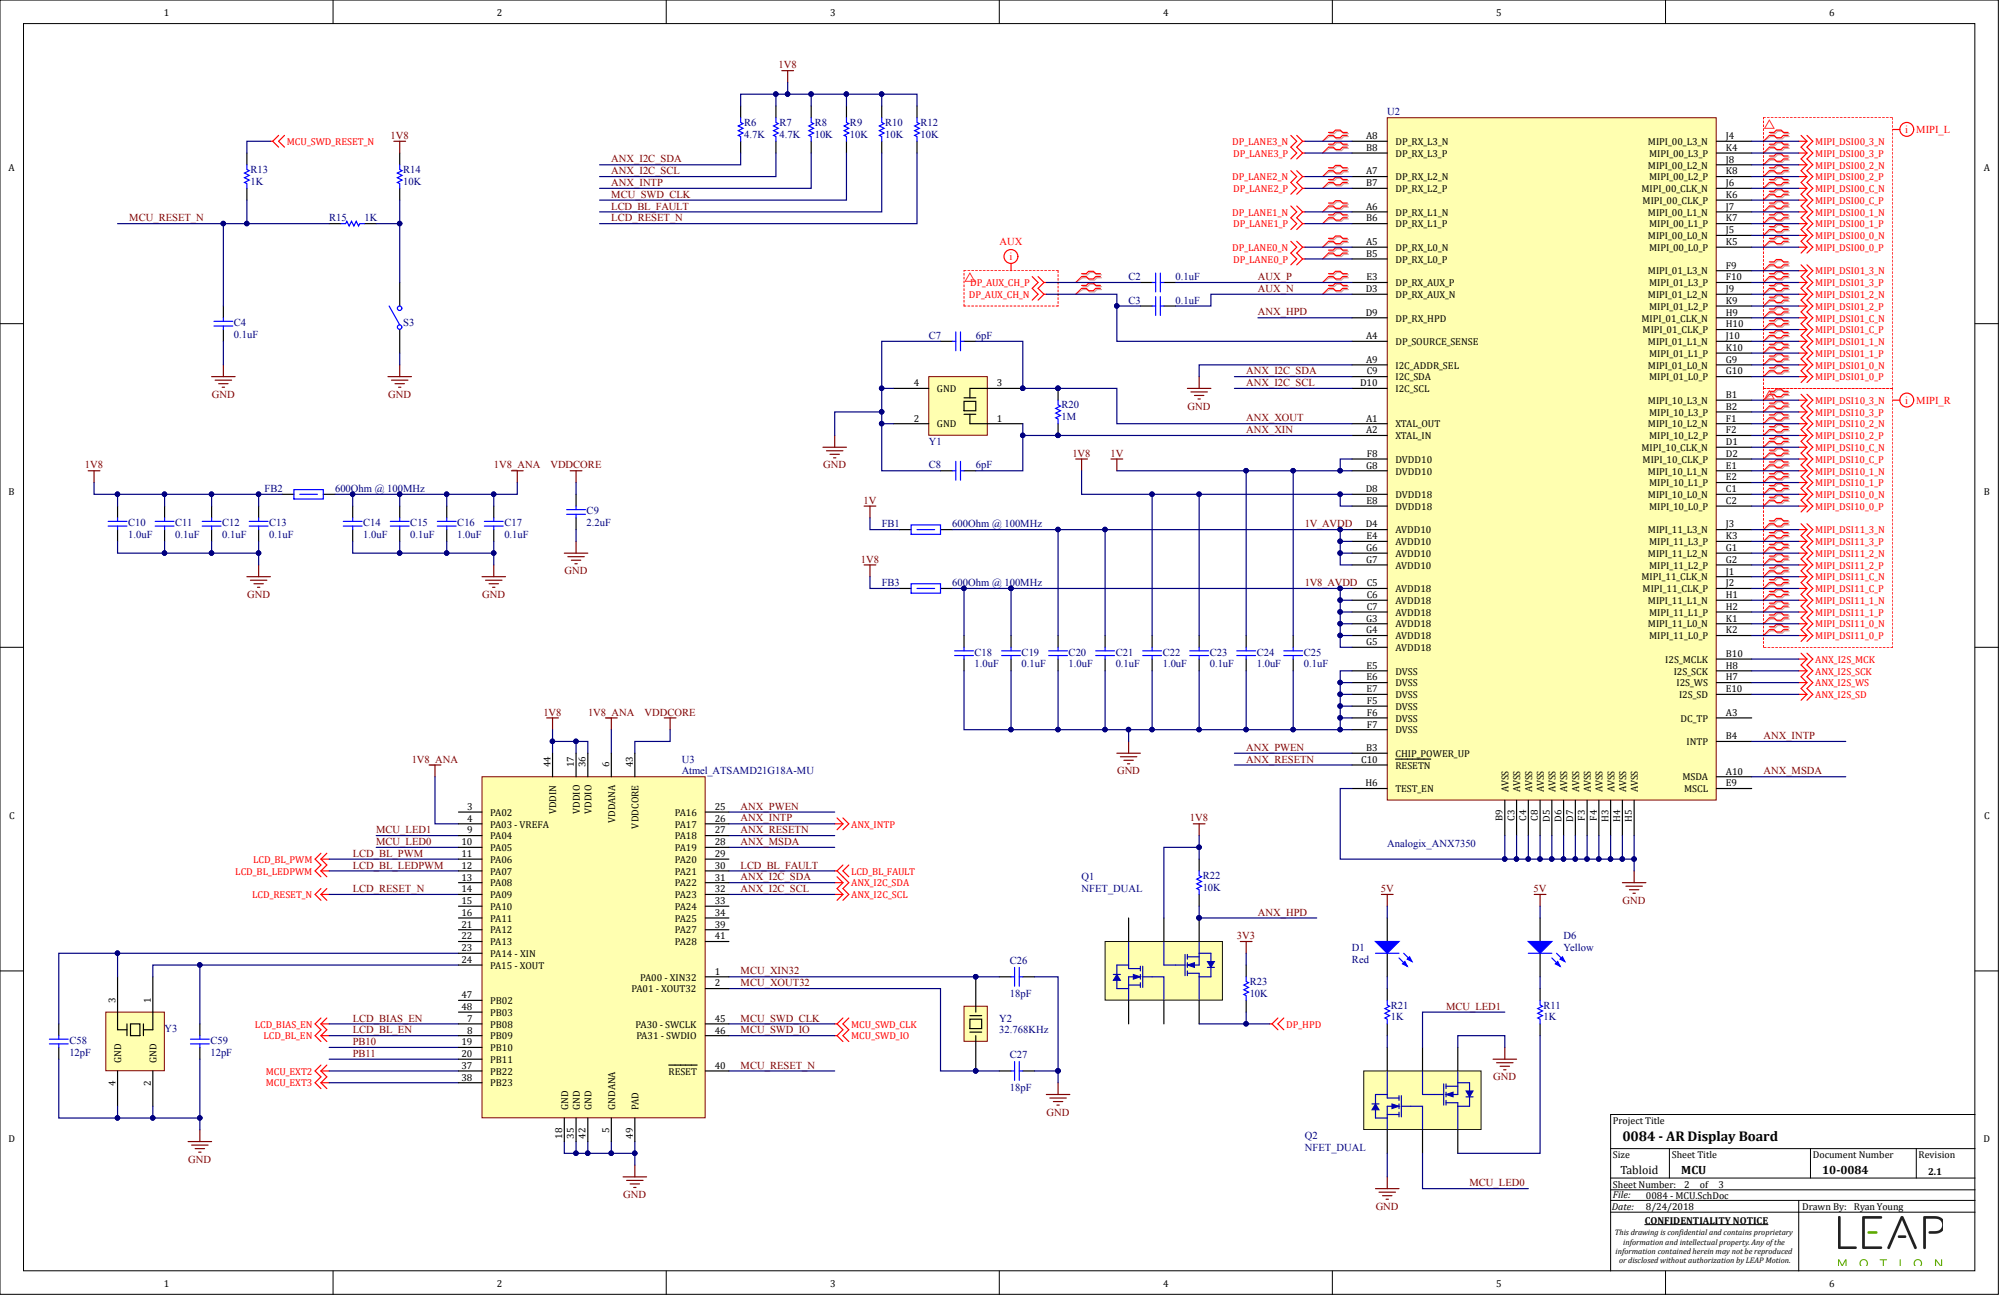
[picture p21: page 2]

AVSS H4 AVSS H3 AVSS F4 AVSS F3 AVSS D7 AVSS D6 AVSS D5 AVSS C8 AVSS C4 AVSS C3 AVSS B9

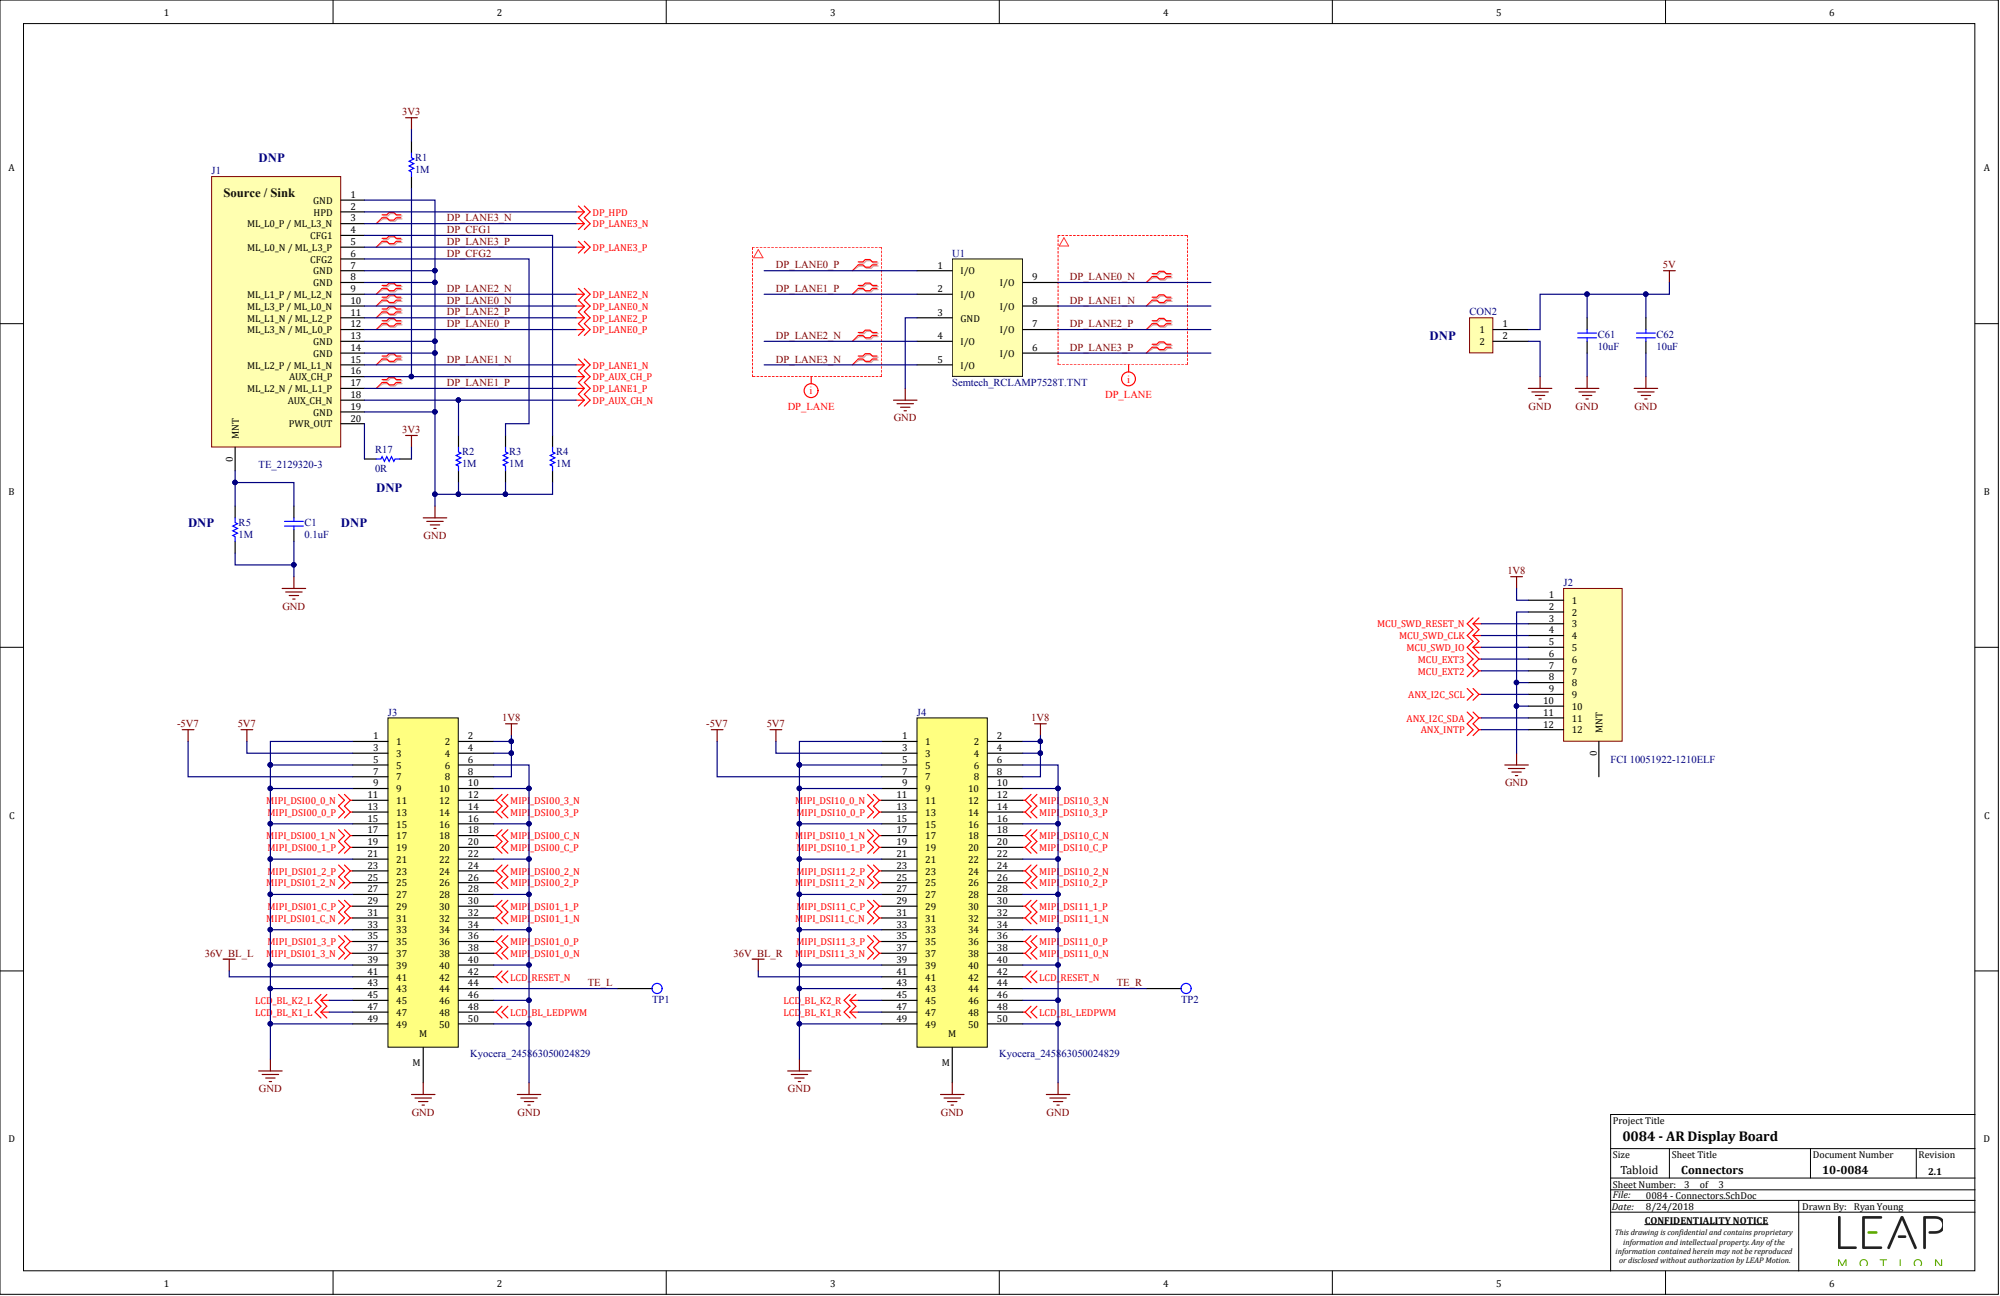
[picture p22: page 3]

3 3
4 4
5 5
6 6 7 7 8 8
