leapmotion/ProjectNorthStar/(list of files, drawings)

Other design files:
Electronics/Hardware/Display Board/0084 - AR Display Board Rev2.1.PcbDoc
Electronics/Hardware/Display Board/0084 - AR Display Board Rev2.1.PrjPcb
Electronics/Hardware/Display Board/0084 - Connectors.SchDoc
Electronics/Hardware/Display Board/0084 - MCU.SchDoc
Electronics/Hardware/Display Board/0084 - Power.SchDoc
