leapmotion/ProjectNorthStar/Electronics/Firmware/src/ArduinoCore/src/core/main.cpp

/*
  Copyright (c) 2015 Arduino LLC.  All right reserved.

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
  You should have received a copy of the GNU Lesser General Public
  License along with this library; if not, write to the Free Software
  Foundation, Inc., 51 Franklin St, Fifth Floor, Boston, MA  02110-1301  USA
*/

#define ARDUINO_MAIN
#include "Arduino.h"

// Weak empty variant initialization function.
// May be redefined by variant files.
void initVariant() __attribute__((weak));
void initVariant() { }

// Initialize C library
extern "C" void __libc_init_array(void);

/*
 * \brief Main entry point of Arduino application
 */
int main( void )
{
  init();

  __libc_init_array();

  initVariant();

  delay(1);
#if defined(USBCON)
  USBDevice.init();
  USBDevice.attach();
#endif

  setup();

  for (;;)
  {
    loop();
    if (serialEventRun) serialEventRun();
  }

  return 0;
}
