leapmotion/ProjectNorthStar/Electronics/Firmware/src/Program/Sketch.cpp

/**
* @file start.cpp
*
* @brief Main program entry point
*
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
* @copyright
* Unless required by applicable law or agreed to in writing, software
* distributed under the License is distributed on an "AS IS" BASIS,
* WITHOUT WARRANTIES OR CONDITIONS OF ANY KIND, either express or implied.
* See the License for the specific language governing permissions and
* limitations under the License.
*
* @author Adam Munich
*/

//#############################################################################
// Includes
//-----------------------------------------------------------------------------
#include <Arduino.h>
#include <Wire.h>
#include <variant.h>

#include "./Sketch.h"
#include "./pin_settings.h"
#include "./display_settings.h"

#include "./Lib_Chicago/Chicago/chicago.h"
#include "./Lib_Chicago/Chicago/chicago_config.h"
#include "./Lib_Chicago/I2C/i2c.h"
#include "./Lib_Chicago/Debug/cmd.h"

#include "./Lib_TPS61194/tps61194.h"


//#############################################################################
// Pre-compiler Definitions
//-----------------------------------------------------------------------------
//#define USE_BACKLIGHT_DRIVER

//#############################################################################
// Variable Declarations
//-----------------------------------------------------------------------------
bool g_bDebug = 0;
#ifdef USE_BACKLIGHT_DRIVER
TPS61194_ TPS61194(PIN_backlight_pwm, PIN_backlight_vsync_in, PIN_lcd_bl_en);
#endif


//#############################################################################
// Function Definitions
//-----------------------------------------------------------------------------
void setup(){
	
	// Pins
	setup_GPIO();
	setup_USART(true, 921600);
	setup_I2C();
	
	// VRPN serial debug
	SerialUSB.begin(921600);
	
	Serial.println("");
	Serial.println("************        Leap Motion        ***********");
	Serial.println("*                Project North Star              *");
	Serial.println("**************************************************");
	Serial.printf("Firmware release: %x.%x.%x\n", ((LEAP_DISPLAY_BOARD_REV & 0xff00) >> 8),
												  ((LEAP_DISPLAY_BOARD_REV & 0x00f0) >> 4),
												   (LEAP_DISPLAY_BOARD_REV & 0x000f));
	Serial.println(buildDate);
	Serial.println(buildTime);
	Serial.printf("Resolution: %dx%d@%dfps\n", PANEL_H_ACTIVE, PANEL_V_ACTIVE, PANEL_FRAME_RATE);
	Serial.println("");
	
	// Backlight driver
#ifdef USE_BACKLIGHT_DRIVER
	TPS61194.setup(
		TPS61194.vsyncModeSetup::vsyncModeOneshot,	// vsyncMode
		PANEL_FRAME_RATE,							// frameRate
		3333,										// oneshot delay (us)
		1667										// oneshot pulse width (us)
	);
	TPS61194.brightness(512);
	TPS61194.powerOn();
#else
	HDK_LCD_BL_ON();
	HDK_LCD_BL_PWM(64);
#endif
	
	// Chicago bridge
	EXT_INTR_ENABLE();
	chicago_state_change(STATE_NONE);
	chicago_last_state_change(STATE_NONE);
	
	// indicate that the device is initialized
	LED_YELLOW_ON();
}

void loop(){		
	cmd();

	if(!g_bDebug)
	{
		chicago_main();
		if(IS_INTR_EVENT())
		{
			chicago_interrupt_handle();
		}
	}
}
