leapmotion/ProjectNorthStar/Electronics/Firmware/src/ArduinoCore/include/core/samd21/include/component/i2s.h

/**
 * \file
 *
 * \brief Component description for I2S
 *
 * Copyright (c) 2015 Atmel Corporation. All rights reserved.
 *
 * \asf_license_start
 *
 * \page License
 *
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
 * 3. The name of Atmel may not be used to endorse or promote products derived
 *    from this software without specific prior written permission.
 *
 * 4. This software may only be redistributed and used in connection with an
 *    Atmel microcontroller product.
 *
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
 * \asf_license_stop
 *
 */

#ifndef _SAMD21_I2S_COMPONENT_
#define _SAMD21_I2S_COMPONENT_

/* ========================================================================== */
/**  SOFTWARE API DEFINITION FOR I2S */
/* ========================================================================== */
/** \addtogroup SAMD21_I2S Inter-IC Sound Interface */
/*@{*/

#define I2S_U2224
#define REV_I2S                     0x102

/* -------- I2S_CTRLA : (I2S Offset: 0x00) (R/W  8) Control A -------- */
#if !(defined(__ASSEMBLY__) || defined(__IAR_SYSTEMS_ASM__))
typedef union {
  struct {
    uint8_t  SWRST:1;          /*!< bit:      0  Software Reset                     */
    uint8_t  ENABLE:1;         /*!< bit:      1  Enable                             */
    uint8_t  CKEN0:1;          /*!< bit:      2  Clock Unit 0 Enable                */
    uint8_t  CKEN1:1;          /*!< bit:      3  Clock Unit 1 Enable                */
    uint8_t  SEREN0:1;         /*!< bit:      4  Serializer 0 Enable                */
    uint8_t  SEREN1:1;         /*!< bit:      5  Serializer 1 Enable                */
    uint8_t  :2;               /*!< bit:  6.. 7  Reserved                           */
  } bit;                       /*!< Structure used for bit  access                  */
  struct {
    uint8_t  :2;               /*!< bit:  0.. 1  Reserved                           */
    uint8_t  CKEN:2;           /*!< bit:  2.. 3  Clock Unit x Enable                */
    uint8_t  SEREN:2;          /*!< bit:  4.. 5  Serializer x Enable                */
    uint8_t  :2;               /*!< bit:  6.. 7  Reserved                           */
  } vec;                       /*!< Structure used for vec  access                  */
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
