leapmotion/ProjectNorthStar/(commit log)

2018-06-06 Initial release
    [Bill of Materials-Project North Star.xls, Optic Positions.step, Reflector Definition.step, arduino_zero.cfg]
2018-06-28 mechanical updates
    - Support for Leap Motion Controller, alternate tracking module
    - Added hinge type for new headgear
    - incremental stiffness and assembly improvements
2018-06-28 added missing slide endcaps
    3D Prints > Optics > end cap.stl
2018-08-31 Display board
    Please update license (PR 15) before committing this change.
    [0084 - AR Display Board Rev2.1.GBL, 0084 - AR Display Board Rev2.1.GBO, 0084 - AR Display Board Rev2.1.GBP, 0084 - AR Display Board Rev2.1.GBS, 0084 - AR Display Board Rev2.1.GM1, 0084 - AR Display Board Rev2.1.GTL, 0084 - AR Display Board Rev2.1.GTO, 0084 - AR Display Board Rev2.1.GTP]
2019-01-18 Fix repository so code builds and runs on driver board
    This is a first pass functional code base. This should build without errors. The resulting binary should load on run on the AR Display Driver Board.
    [Sketch.cpp, display_settings.h, pin_settings.h, startup.c]
2019-01-18 Modify UART Output
    Making it a little more verbose on start-up with useful information and suppressing information that is only useful for debugging.
2019-01-24 Mechanical release 3
    Added adjustments and mechanisms for a larger variety of heads and facial geometries. Overall, the assembly is stiffer and more comfortable to wear
    [BOM_North Star Assm - Release 3 Rev 1.tsv, Optic Positions.step, Reflector Definition.step]
2019-01-24 Added Driver for Backlight
2019-01-25 pound defined choice to include backlight driver
    For the time being, I'm going to make the selection to include the backlight driver optional.
2019-02-13 fixed typo, missing files, wrong references
    exported newer versions of #210-001 and #121-002 and added FDM optimized versions to STL folder. Fixed incorrect filename for #110-002. Besides #210-001, changes are aesthtic or very minor. #210-001 can now print without support material.
2019-02-20 Updated BOM to remove confusion
    25cm focal displays are suggested for first time builds because it's marginally simpler during software calibration step. However, focal distance should be chosen based on the applications you're building.
    [BOM_North Star Assm - Release 3 Rev 1.tsv]
2019-03-09 Add Internal Calibrator
    The source code for this is included in the unitypackage as well...
2019-03-09 Added calibration stand
    [Calibration Stand CAD.step]
2019-03-23 Added 3D files for simplified optics assembly
    reduces part count, reduces need for support material
2019-04-02 added drawings and updated BOM with #130-000 assm
    Updated BOM quantities, added calibration stand BOM, added assembly drawings of #130-000 and #131-000
    [BOM_North Star Assm - Release 3 Rev 1.tsv, BOM_North Star Assm.tsv, BOM_North Star Calibration Stand.tsv]
2019-04-02 updated #100-000 drawing
    added note about simplified optics bracket assembly #130-000
2019-04-05 fixed missing BOM items
    [BOM_North Star Assm.tsv]
2019-04-12 Fixed oversize chamfer, removed unecessary lip around rubber washer
    Screws may push against and deform the displays if you torque them down too hard. The issue is the chamfer on the hole is too large. If a screw is torqued down hard enough to deform the plastic, then the tip of screw starts pushing into the display. It's not an issue on the 25cm trays because the displays are further from the screws.
2019-04-19 Added modular lid with vive tracker mount
    [Blank Mounting Plate.step, Calibration Stand CAD.step, Optic Positions.step, Reflector Definition.step]
2019-08-22 Minor update to strengthen some parts and make assembly easier (see CHANGELOG), clean CAD export and update 3.1 BOM, restructure Mechanical folders
    [BOM North Star Release 3.tsv, BOM North Star Update 3.1.tsv, BOM_North Star Assm.tsv, BOM_North Star Calibration Stand.tsv, Blank Mounting Plate.step, Calibration Stand CAD.step, Optic Positions.step, Reflector Definition.step]
2019-12-14 Added missing STL exports, #131-001,2
2020-04-29 Added development folder with WIP CAD
2020-05-01 Adjusted optics bracket reflector fit
2020-05-01 Replaced CAD format with IGES
    STEP was failing to properly export and import geometry
2020-05-12 Added back missing cable guide part, adjusted forehead padding part
    Increased thickness, width, and height of forehead part for stiffness and better stability. Cable guide needs to be heat formed after printing
